Gazelle8087/Si4730-AM-FM-tuner/LED UI仕様.pdf

## LED表示UI仕様 2026/7/4時点未実装

LED番号 | 想定色 | | 点灯条件 複数は&& 数値はソースで定義 | 基板シルク表示 | 備考
1 | 白 | AM | SNR○○以上 帯域○klHz以上指示 | Hi-Fi | 最高の受信状態
| | FM | SNR○○以上 STBLEND○○以上 MULT○○以下 | FULL STEREO
2 青 | | AM | SNR○○以上 | CLEAR | 良好な受信状態
| | FM | PILOT検出 オートミュートON オートミュート不動作 強制モノラル OFF | STEREO PILOT | ステレオインジケーター
3 緑 | | AM | RSSI○○以上 | TUNE | 受信あり
| | FM | RSSI○○以上 | | 受信あり
4 | 赤 | 共通 | 微調整モード中 | FINE TUNING | 微調整モード表示
