Gazelle8087/Si4730-AM-FM-tuner/リモコンUI仕様.pdf

## リモコンUI仕様 2026/7/19時点

ボタン表示 | ボタンの働き | 備考
電源記号 | 音声mute ON/OFF トグル （電源 ON/OFFではない）
入力切替 | 予約（現状無動作）
放送切替 | AM/FM 切替トグル
音量+ | 音量+
音量- | 音量-
▲（上） | AM FM | 通常時：+9kHz 微調整：+1kHz | 通常時、9加算結果は9単位に丸められる　例 722▲⇒729
| | 通常時：+0.1MHz (100kHz) 微調整：+0.01MHz (10kHz) | 通常時、0.1加算結果は0.1単位に丸められる　例 82.42▲⇒82.5
▼（下） | AM FM | 通常時：-9kHz 微調整：-1kHz | 通常時、9減算結果は9単位に丸められる　例 722▼⇒720
| | 通常時：-0.1MHz (100kHz) 微調整：-0.01MHz (10kHz) | 通常時、0.1減算結果は0.1単位に丸められる　例 82.42▼⇒82.4
←（左） | | 通常時：プリセットCH-微調整：帯域幅（cannnel filter）-
→（右） | | 通常時：プリセットCH+ 微調整：帯域幅（cannnel filter）+
決定（中央） | | 通常/微調整 切替トグル | 十字キーの動きを切替
d | | 周波数直打(direct tuning) | 続けて数値3または4桁入力（AM 1kHz単位 FM 100kHz単位） 0～9以外入力された場合、キャンセル扱い
戻る | | 操作キャンセル | 周波数直打/プリセットメモリ書込CH選択キャンセル
メニュー | | プリセットバンク切替 | 続けて押されたch番号⇒バンク番号
番組表 | | プリセットメモリ書込 | 続けて押されたchに書き込み（選択中のバンク内ｃｈ）
青 | AM | 予約（現状無動作） | 同調容量指示（将来実装）
| FM | 強制モノラル ON/OFF トグル
赤 | AM | 予約（現状無動作） | オートボリューム操作（将来実装）
| FM | 予約（現状無動作） | オートミュート ON/OFF トグル（将来実装)
緑 | AM | RSQ定期更新停止/開始 トグル | 受信周波数変更で解除
FM
黄 | AM | 予約（現状無動作） | ゲイン値 強制指定（将来実装）
| FM | 予約（現状無動作）
1 | | 通常時：プリセットメモリ呼出 プリセットメモリ書込時： 書込CH指定 CHボタン以外押されたら キャンセル扱い プリセットバンク切替時： 選択するバンクNo指定 CHボタン以外押されたら キャンセル扱い 周波数直打時：数値キー 10 ⇒ 0 11 ⇒ キャンセル扱い 12 ⇒ キャンセル扱い | 選択中のプリセットバンク内の chボタンで指定されたチャンネルメモリを呼び出し AM/FM混合ランダム指定可能 AM/FM種別 周波数　帯域幅 強制モノラル を記憶する 合計144chプリセット バンク、ch 共に 1～9,A,B,C 表示
10 | ボタンの「10」はCHは10 周波数直打時は0 と解釈
11 | 11,12 は周波数直打数値キーとしては無効（キャンセル扱い）

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
