Gazelle8087/Si4730-AM-FM-tuner/搭載LCD仕様一覧.pdf

搭載LCD型番仕様差　搭載方向ごとの周辺RC実装要否
型式 | 型番 | 秋月 販売コード | バック ライト色 | 背景色 | 文字色 | 搭載方向 | R13 | R14 | R15 | R21 | C10 | C12 | C13 | C14 | C15 | C16
薄型 DIP変換KIT付 | AE-AQM1602A(KIT) | 108896 | - | 白 | 黒 | 正立 倒立 | × | × | × | × | × | × | × | × | × | ×
薄型 1.27mmピッチ | AQM1602XA-RN-GBW | 108779 | - | 白 | 黒 | 正立 | ○ | ○ | × | ○ | × | × | × | ○ | ○ | ○
| | | | | | 倒立 | ○ | ○ | ○ | × | ○ | ○ | ○ | × | × | ×
超小型 2.54mmピッチ | AQM1602Y-RN-GBW | 111916 | - | 白 | 黒 | 正立 | ○ | ○ | ○ | × | ○ | ○ | ○ | × | × | ×
| AQM1602Y-NLW-BBW | 112485 | 白 | 青 | 白
| AQM1602Y-NLW-FBW | 112486 | 白 | 黒 | 白
| AQM1602Y-FLB-FBW | 112618 | 青 | 青 | 白
| AQM1602Y-FLW-FBW | 112619 | 白 | 白 | 黒
| AQM1602Y-RN-GBW | 111916 | - | 白 | 黒 | 倒立 | ○ | ○ | × | ○ | × | × | × | ○ | ○ | ○
| AQM1602Y-NLW-BBW | 112485 | 白 | 青 | 白
| AQM1602Y-NLW-FBW | 112486 | 白 | 黒 | 白
| AQM1602Y-FLB-FBW | 112618 | 青 | 青 | 白
| AQM1602Y-FLW-FBW | 112619 | 白 | 白 | 黒

薄型 DIP変換KIT付使う場合はピッチ変換基板上のプルアップジャンパをON（ショート）
