Gazelle8087/Si4730-AM-FM-tuner/LCD表示UI仕様.pdf

LCD表示UI仕様 2026/7/4時点

1 2 3 4 5 6 7 8 9 10 11 12 13 14 15 16
AM | P b c | 1 0 5 3 < v v | 6 . 0
R r r | S s s A a a C c c c
FM | P b c 8 2 . 5 0 < v v | 1 1 0
R r r | S s s Mmm B b b b
| 桁
1行目 | 1-3 | Pbc　b：バンク番号 c：ch番号
| 5-9 | 周波数表示
| 10 | ファインチューニング時 < 表示　通常時 空白
| 11-12 | 音量表示 音声mute時は [--]
| 14-16 | チャンネルフィルタ値　FM自動選択維持はAと表示
2行目 | 1-3 | Rrr RSSI値
| 5-7 | Sss SNR値
| 9-11(AM) | Aaa ATT値
| 9-11(FM) | Mmm マルチパス指標
| 13-16（AM) | Cccc 同調バリキャップ容量 ( pF )
| 13-16(FM) | Bbbb ステレオブレンド値 ( % ) PILOT検出時 [B] 表示 強制モノラル時 [---]表示
