Gazelle8087/Si4730-AM-FM-tuner/部品表.pdf

部品表
| 部品番号 | 型番 または諸元 | 個数 | 購入可能ショップ（例）ショップURL または 秋月販売コード
プリント基板 | | | 1 | JLCPCB | https://jlcpcb.com/jp
チューナーモジュール | | Si4730-M02 | 1 | 共立エレショップ | https://eleshop.jp/shop/g/gQ1D411
液晶表示器 | | AE-AQM1602A(KIT) | 1 | 秋月電子 | 108896 薄型液晶DIP変換キットを標準仕様とします
マイコン | U2 | ATMEGA328P-PU | 1 | 秋月電子 | 103142
丸ピンICソケット | U2 | 28ピン 300mil | 1 | 秋月電子 | 101339
ミュートトランジスタ | Q1,Q2 | 2SC2878 | 2 | 樫木総業 | https://www.kashinoki.shop/?mode=srh&cid=&keyword=2SC2878
赤外線受光器 | U3 | OSRB38C9AA | 1 | 秋月電子 | 104659 （2個セット）
3.3Vレギュレータ | U1 | LP2950L-33-T92 | 1 | 秋月電子 | 108749
ショットキーダイオード | D3 | 1S4 | 1 | 秋月電子 | 100127
スイッチングダイオード | D8 | 1SS178 | 1 | 秋月電子 | 107783 （100本セット）
DCジャック | J3 | 内径2.1 外径5.5 | 1 | 秋月電子 | 109408
RCAジャック | J5 | MJ-523-W 白 | 1 | 秋月電子 | 116497
RCAジャック | J6 | MJ-523-R 赤 | 1 | 秋月電子 | 116498
3.5mmステレオジャック | J7 | ST-005-G | 1 | 秋月電子 | 102460
電源スイッチ | J2 | SS-12D00G3 | 1 | 秋月電子 | 115707
リセットスイッチ | SW1 | タクトスイッチ | 1 | 秋月電子 | 103648
ヘッダピン | J12 | PH-1x40SG | 1 | 秋月電子 | 108593 （10個セット）
ジャンパプラグ | J12 | MJ-254-6R | 1 | 秋月電子 | 103688 （25個セット） USB-シリアルアダプタ経由給電時にセット
シリアルヘッダ | J11 | L型 6P | 1 | 秋月電子 | 105336
インダクタ | FB2,3 | 10μH | 2 | 秋月電子 | 103963 （10本セット）
アルミ電解コンデンサ | C19,20 | 100μF | 2 | 秋月電子 | 110271
アルミ電解コンデンサ | C4,6,8 | 10μF | 3 | 秋月電子 | 117897
積層セラミックコンデンサ | C5,7,9,11,17,18,24 | 0.1μF | 7 | 秋月電子 | 113582 （10個セット） C21は実装しない（設計ミス）
抵抗 | R1 | 33kΩ 1/6W | 1 | 秋月電子 | 116333 （100本セット）
↑ | R4,5 | 22kΩ 1/6W | 2 | 秋月電子 | 116223 （100本セット）
↑ | R2,18,21,22 | 10kΩ 1/6W | 4 | 秋月電子 | 116103 （100本セット）
↑ | R3,6,C7 | 1kΩ 1/6W | 3 | 秋月電子 | 116102 （100本セット）
↑ | C16,17,23,24 | 100Ω 1/6W | 4 | 秋月電子 | 116101 （100本セット）

機能使うなら実装するオプション部品
USB-Aコネクタ | J8 | 5075AR-04-WH | 1 | 秋月電子 | 100160 DAISO 300円スピーカーに電源供給するなら実装
電源パイロット LED | D2 | お好みの色 | 1 | | パイロットLEDは5Vから供給
抵抗 パイロット電流制限 | R8 | 輝度見ながら調整 | 1
抵抗 LCDバックライト用 | R19, R20 | 輝度見ながら調整 | 2 | | バックライトは5Vから供給
ヘッダピン | J17 | 2×3 | 1 | 秋月電子 | 116883 ICSPヘッダ
LCD用抵抗 | R13,14 | 10kΩ | 1 | 秋月電子 | 116103 （100本セット）超小型LCD搭載の場合に実装（方向問わず）
LCD用抵抗 | R15 | 10kΩ | 1 | 秋月電子 | 116103 （100本セット）超小型LCDを非反転で搭載する場合に実装
LCD用コンデンサ | C10,12,13 | 1μF | 3 | 秋月電子 | 115940 （10個セット） 超小型LCDを非反転で搭載する場合に実装
LCD用抵抗 | R21 | 10kΩ | 1 | 秋月電子 | 116103 （100本セット）超小型LCDを上下反転で搭載する場合に実装
LCD用コンデンサ | C14,15,16 | 1μF | 3 | 秋月電子 | 115940 （10個セット） 超小型LCDを上下反転で搭載する場合に実装
積層セラミックコンデンサ | C1,2 | 0.1～1μF | 2 | | ポップノイズチューニング用
マイコン横ピンソケット | J15,16 | 14ピン | 2 | 秋月電子 | デバッグ用にジャンパワイヤ刺す際に便利

基板にパターンはあるが実装しないファームウエア未対応部品
整流ダイオード | D1 | 1N4007 | 1 | | 100934（20本セット）
インダクタ | FB1 | 10μH | 1
水晶発振子 | Y1 | 8MHz | 1 | | Arduino UNO等から取り外したマイコンにブートローダー
水晶発振負荷コンデンサ | C22,C23 | 22pF | 2 | | 書き込む際には必要な場合あり
UI用LED | D4 | お好みの色 | 1
UI用LED | D5 | お好みの色 | 1
UI用LED | D6 | お好みの色 | 1
UI用LED | D7 | お好みの色 | 1
抵抗 LED用 | R9 | 輝度見ながら調整 | 1
抵抗 LED用 | R10 | 輝度見ながら調整 | 1
抵抗 LED用 | R11 | 輝度見ながら調整 | 1
抵抗 LED用 | R12 | 輝度見ながら調整 | 1
SPI接続 7SEG LED | | 7SEG 8桁 | 1 | Amazon等
パスコン 7SEG LED用 | C3 | 0.1μF | 1

スケッチ書き込みに使うUSB-シリアルアダプタ
USB-シリアルアダプタ | AE-TTL-232R | 1 | 秋月電子 | 111007
マイクロUSBケーブル | | 1 | 秋月電子 | 107607

ACアダプタ
5VＡＣアダプタ | AD-T50P200 | 1 | 秋月電子 | 111996　USB-シリアルアダプタから給電する場合は不要

リモコン送信機
ELPA TVリモコン | RC-TV013UD | 1 | ホームセンタ 家電量販店など | https://www.elpadirect.jp/products/4901087205325/

アンテナ

AMループアンテナ | 1 | Amazonなど | リード線先端がコネクタではなく裸線の物をご用意ください

木道家屋または窓際設置であればAMはループアンテナで十分受信可能　FMはワイヤーアンテナでは良好な受信は期待できません
