Gazelle8087/Si4730-AM-FM-tuner/Si4730-M02_manual.JPG

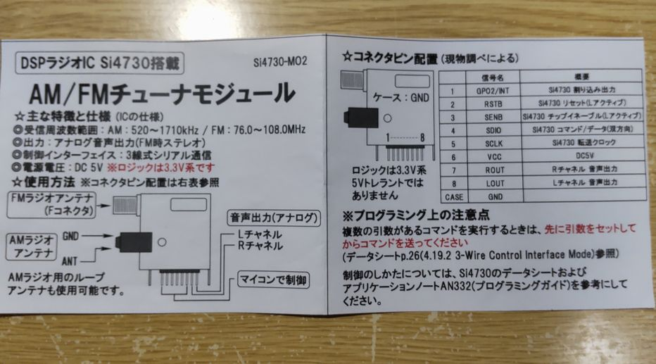
Si4730-M02_manual.JPG
