Gazelle8087/Si4730-AM-FM-tuner/使ったリモコン_rc-tv013ud_manual.pdf

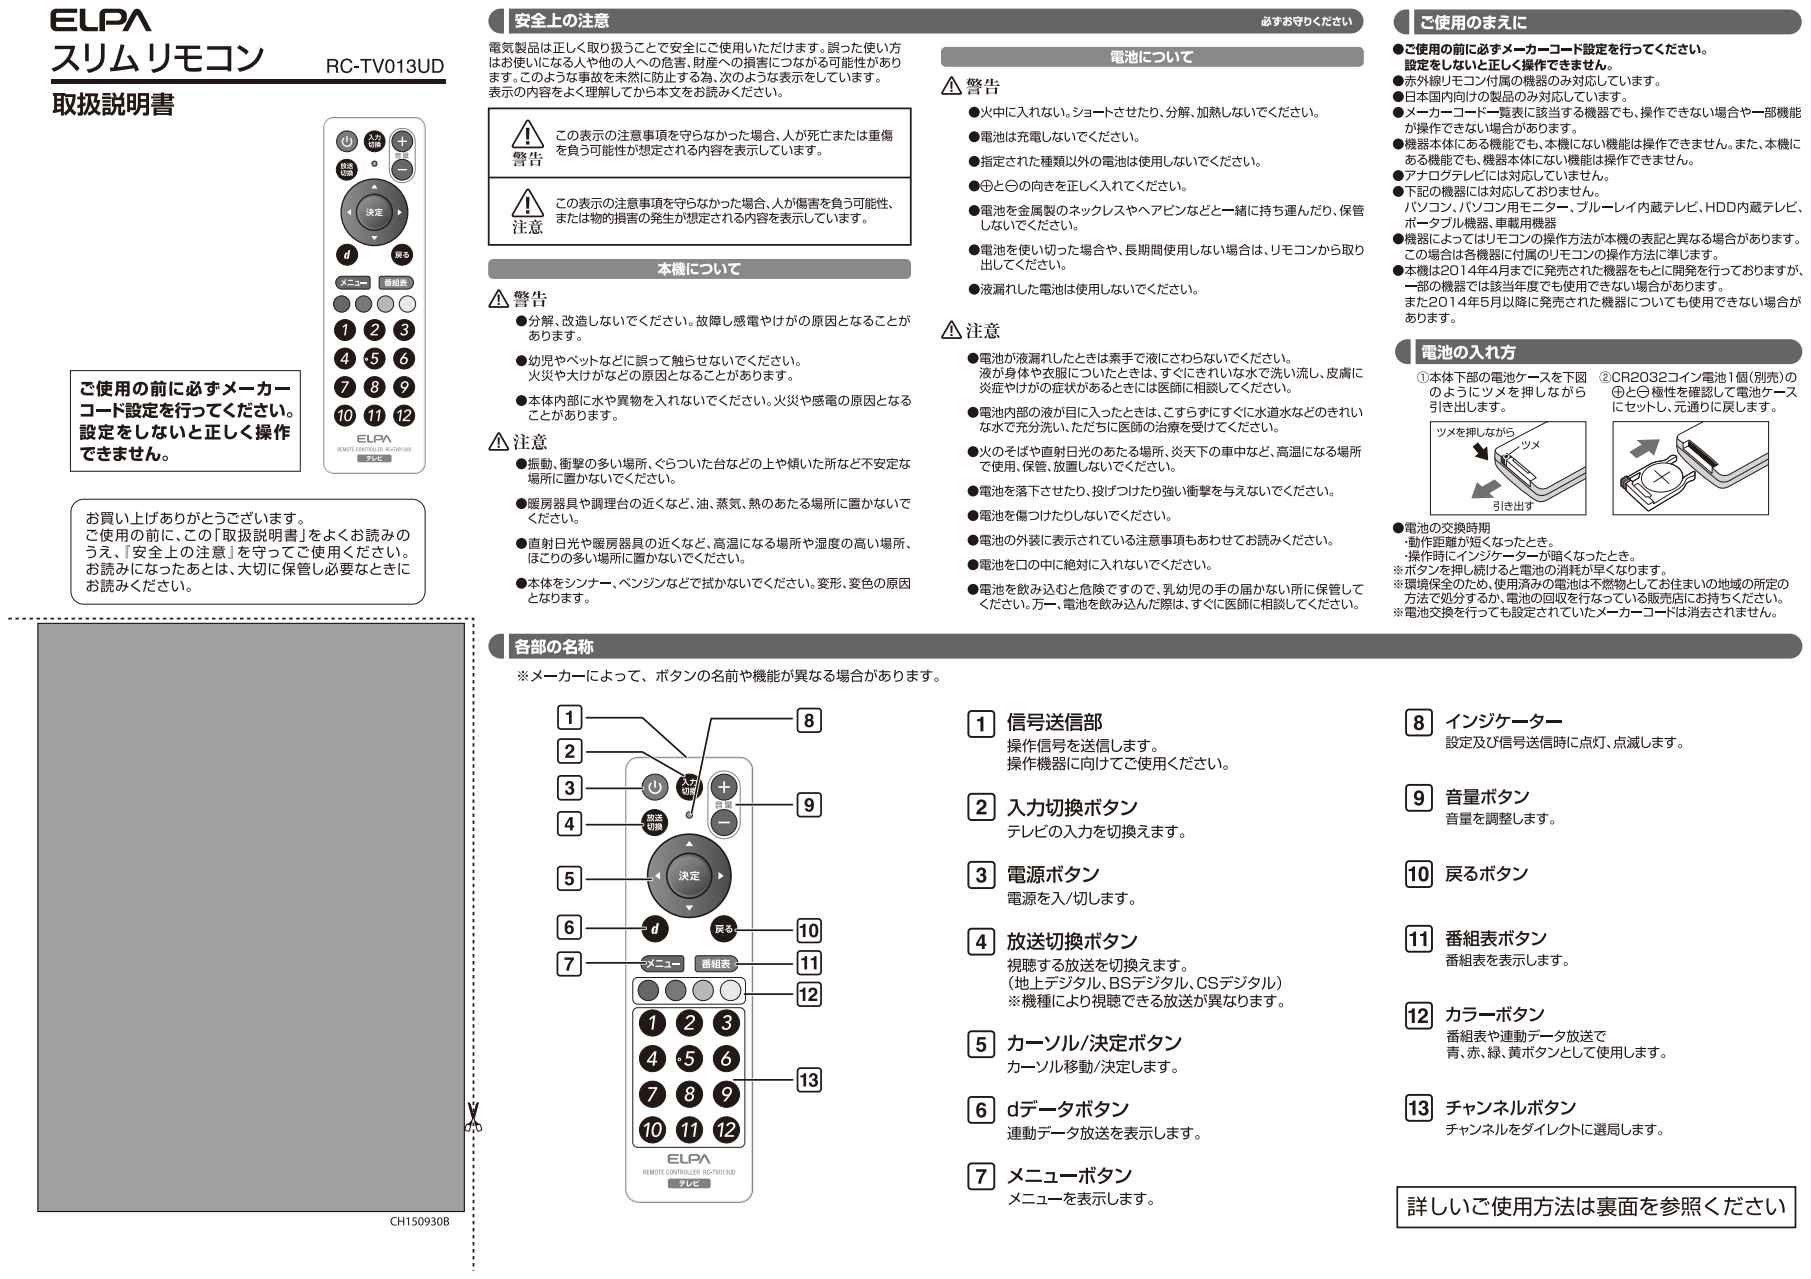
[picture p6: page 1]

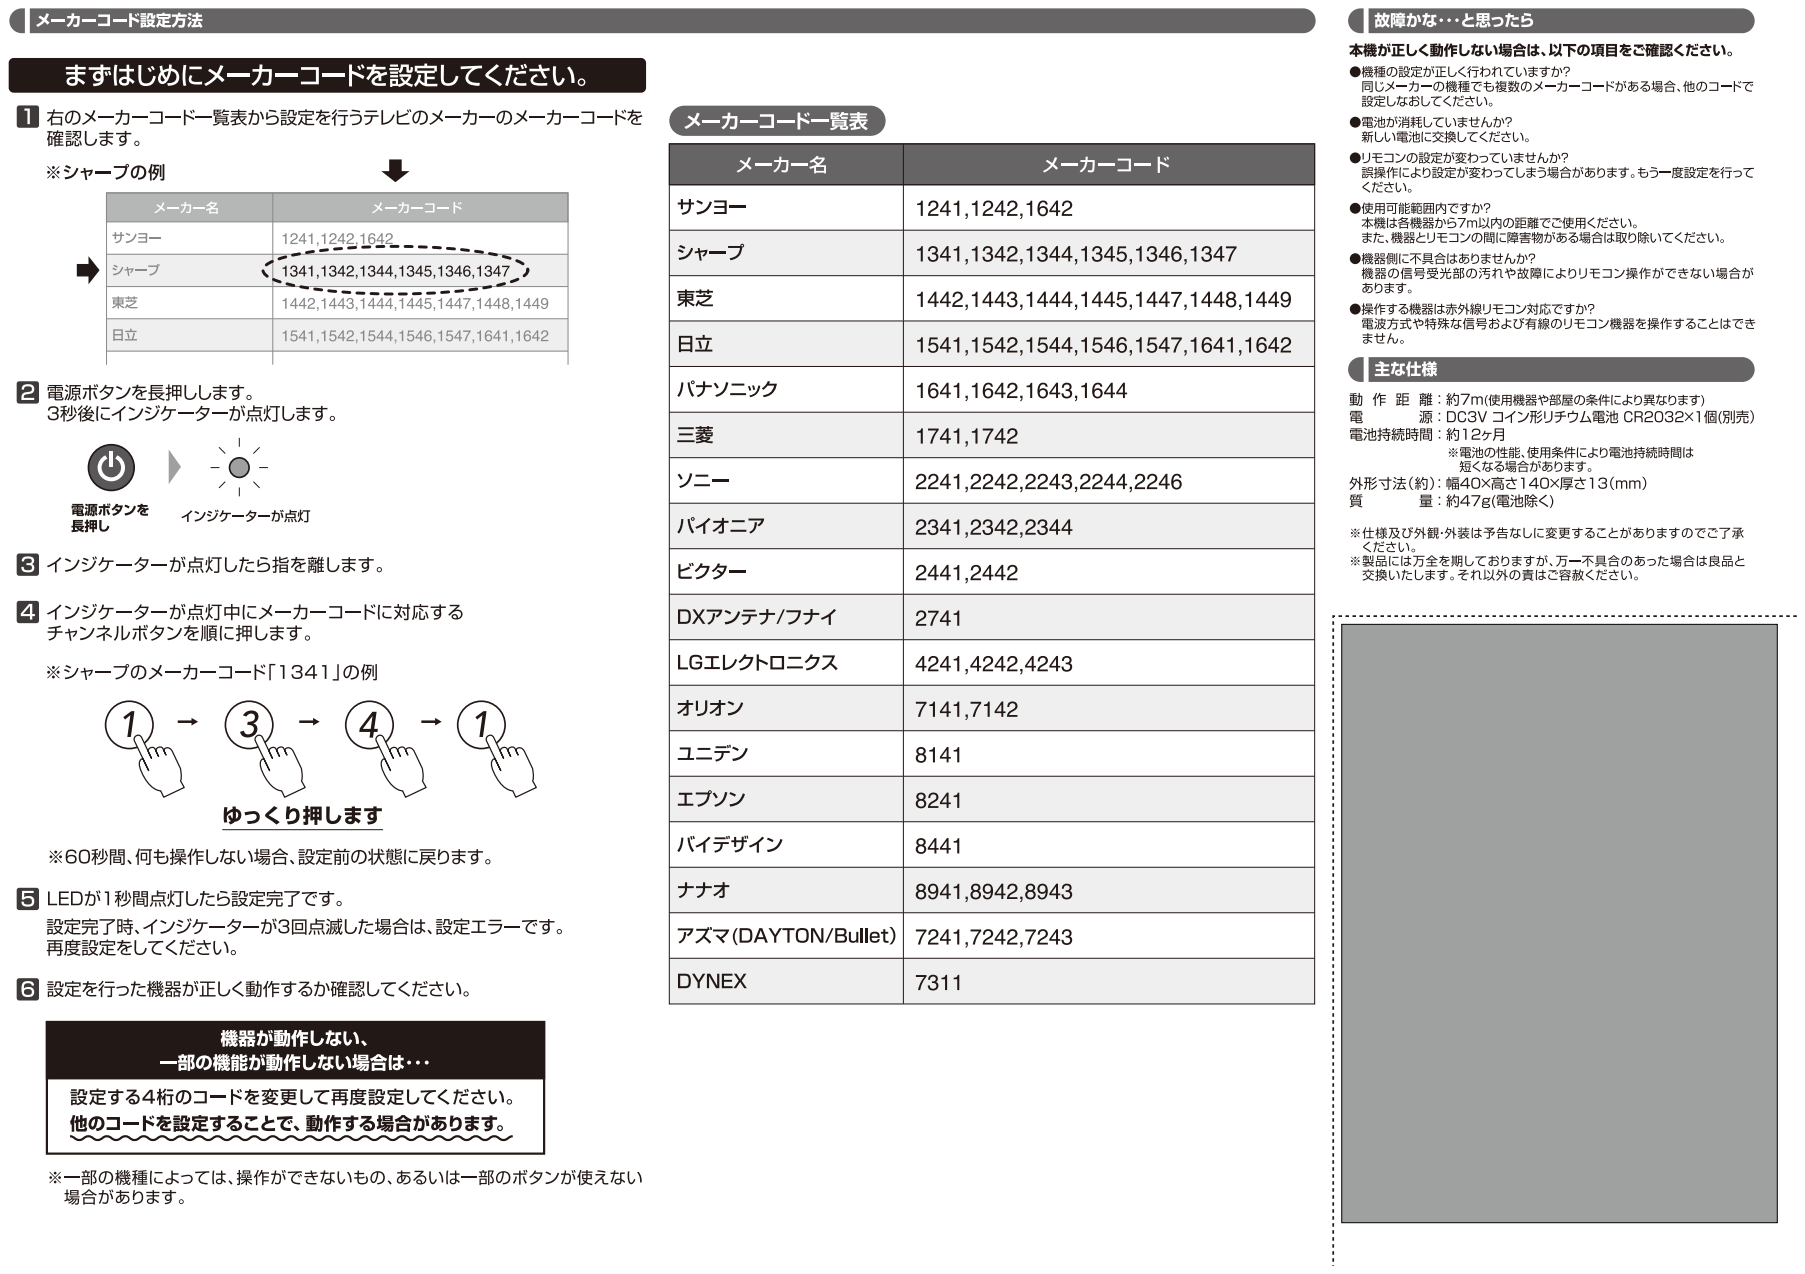
[picture p7: page 2]
