Gazelle8087/Si4730-AM-FM-tuner/Si4730-M02_Tuner_sch.pdf

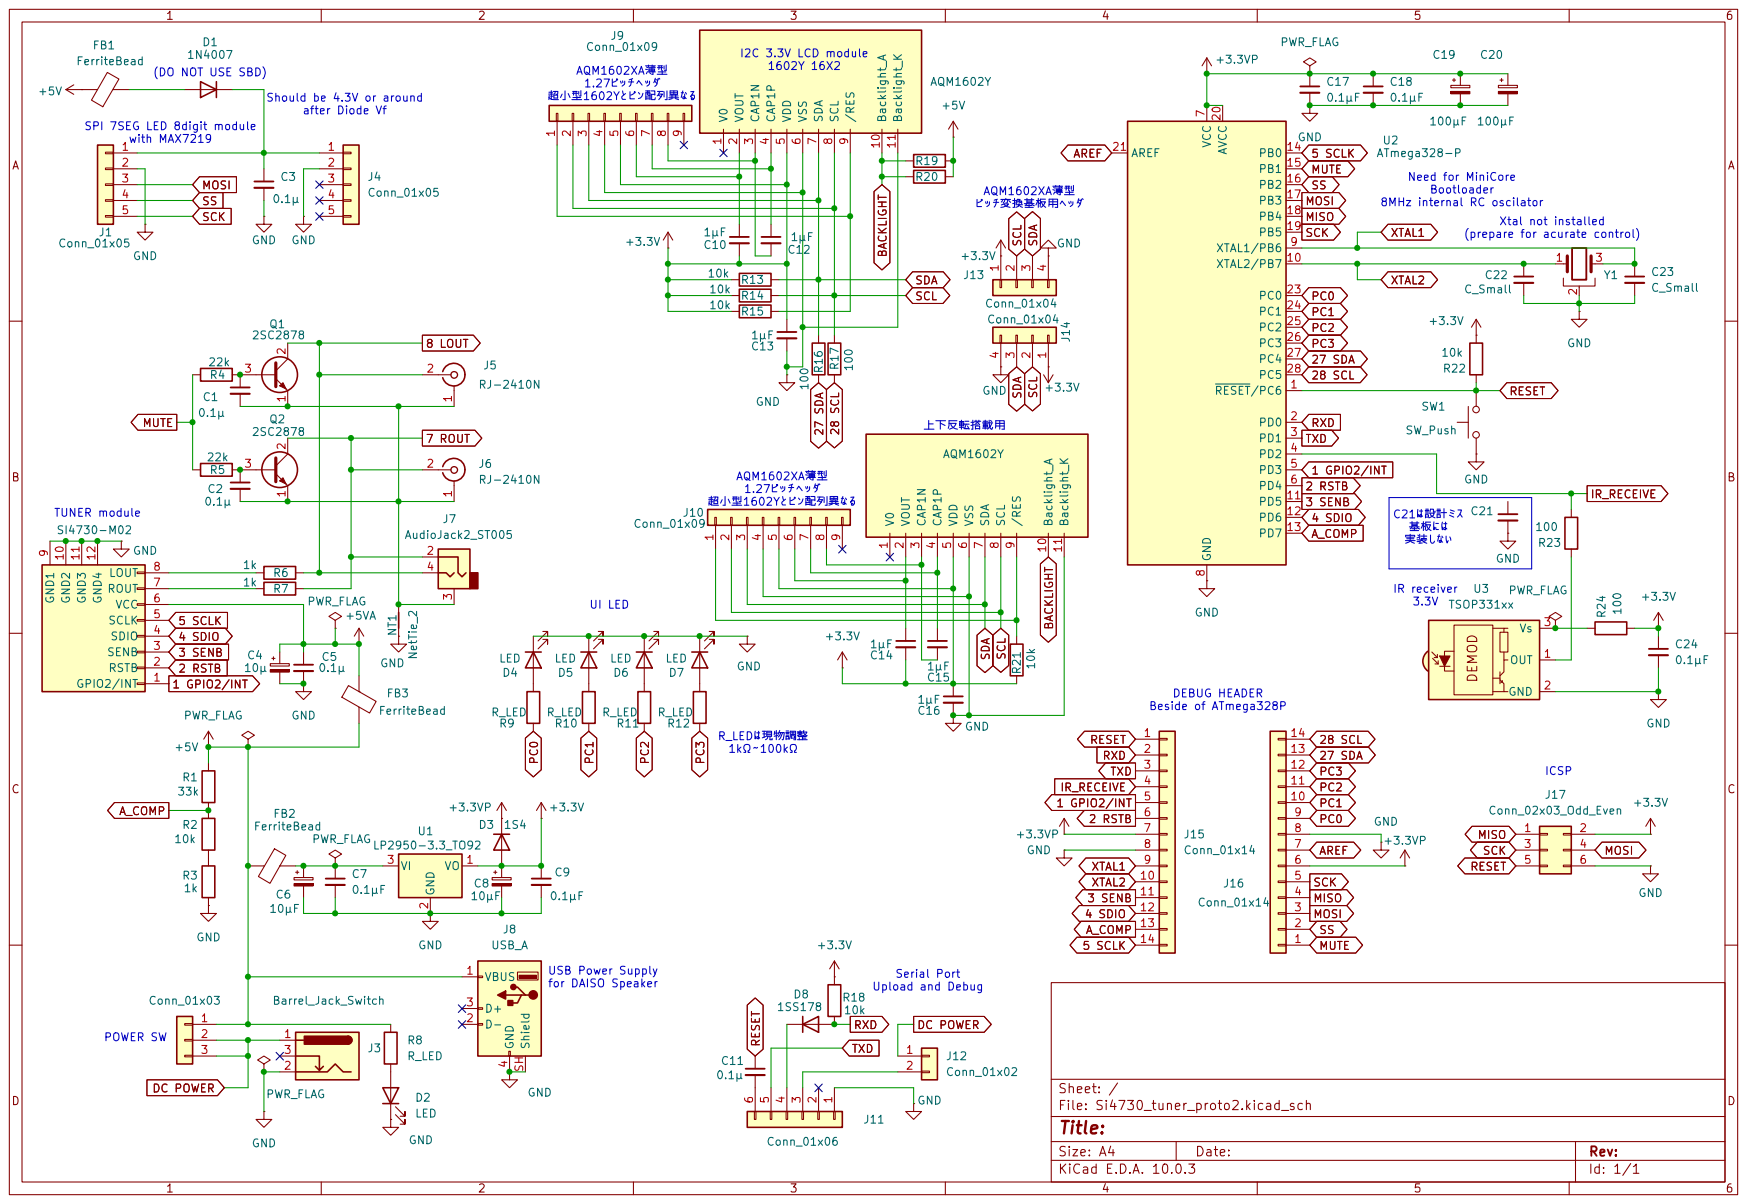
[picture p8: page 1]
