Gazelle8087/Si4730-AM-FM-tuner/Si4730-M02_sch.pdf

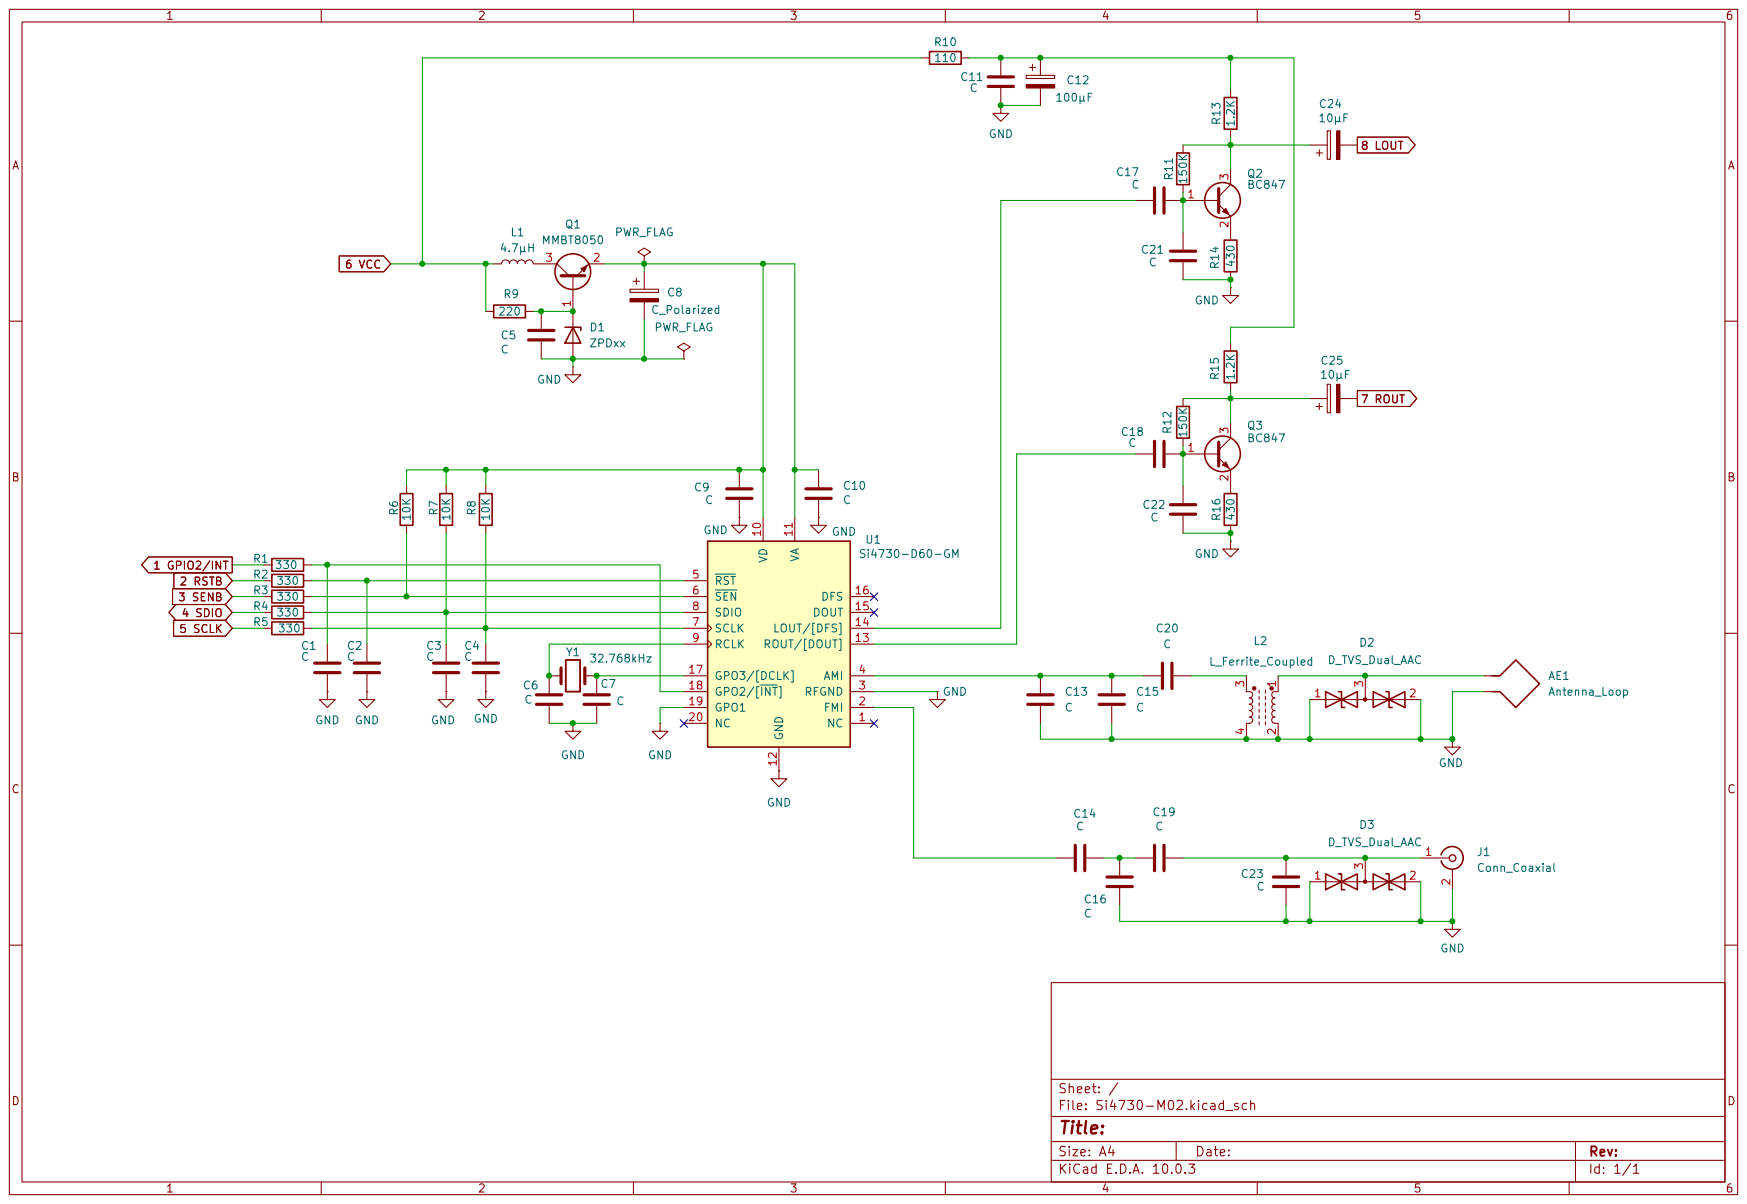
[picture p9: page 1]
