Gazelle8087/Si4730-AM-FM-tuner/5075AR-04-WH-F1.pdf

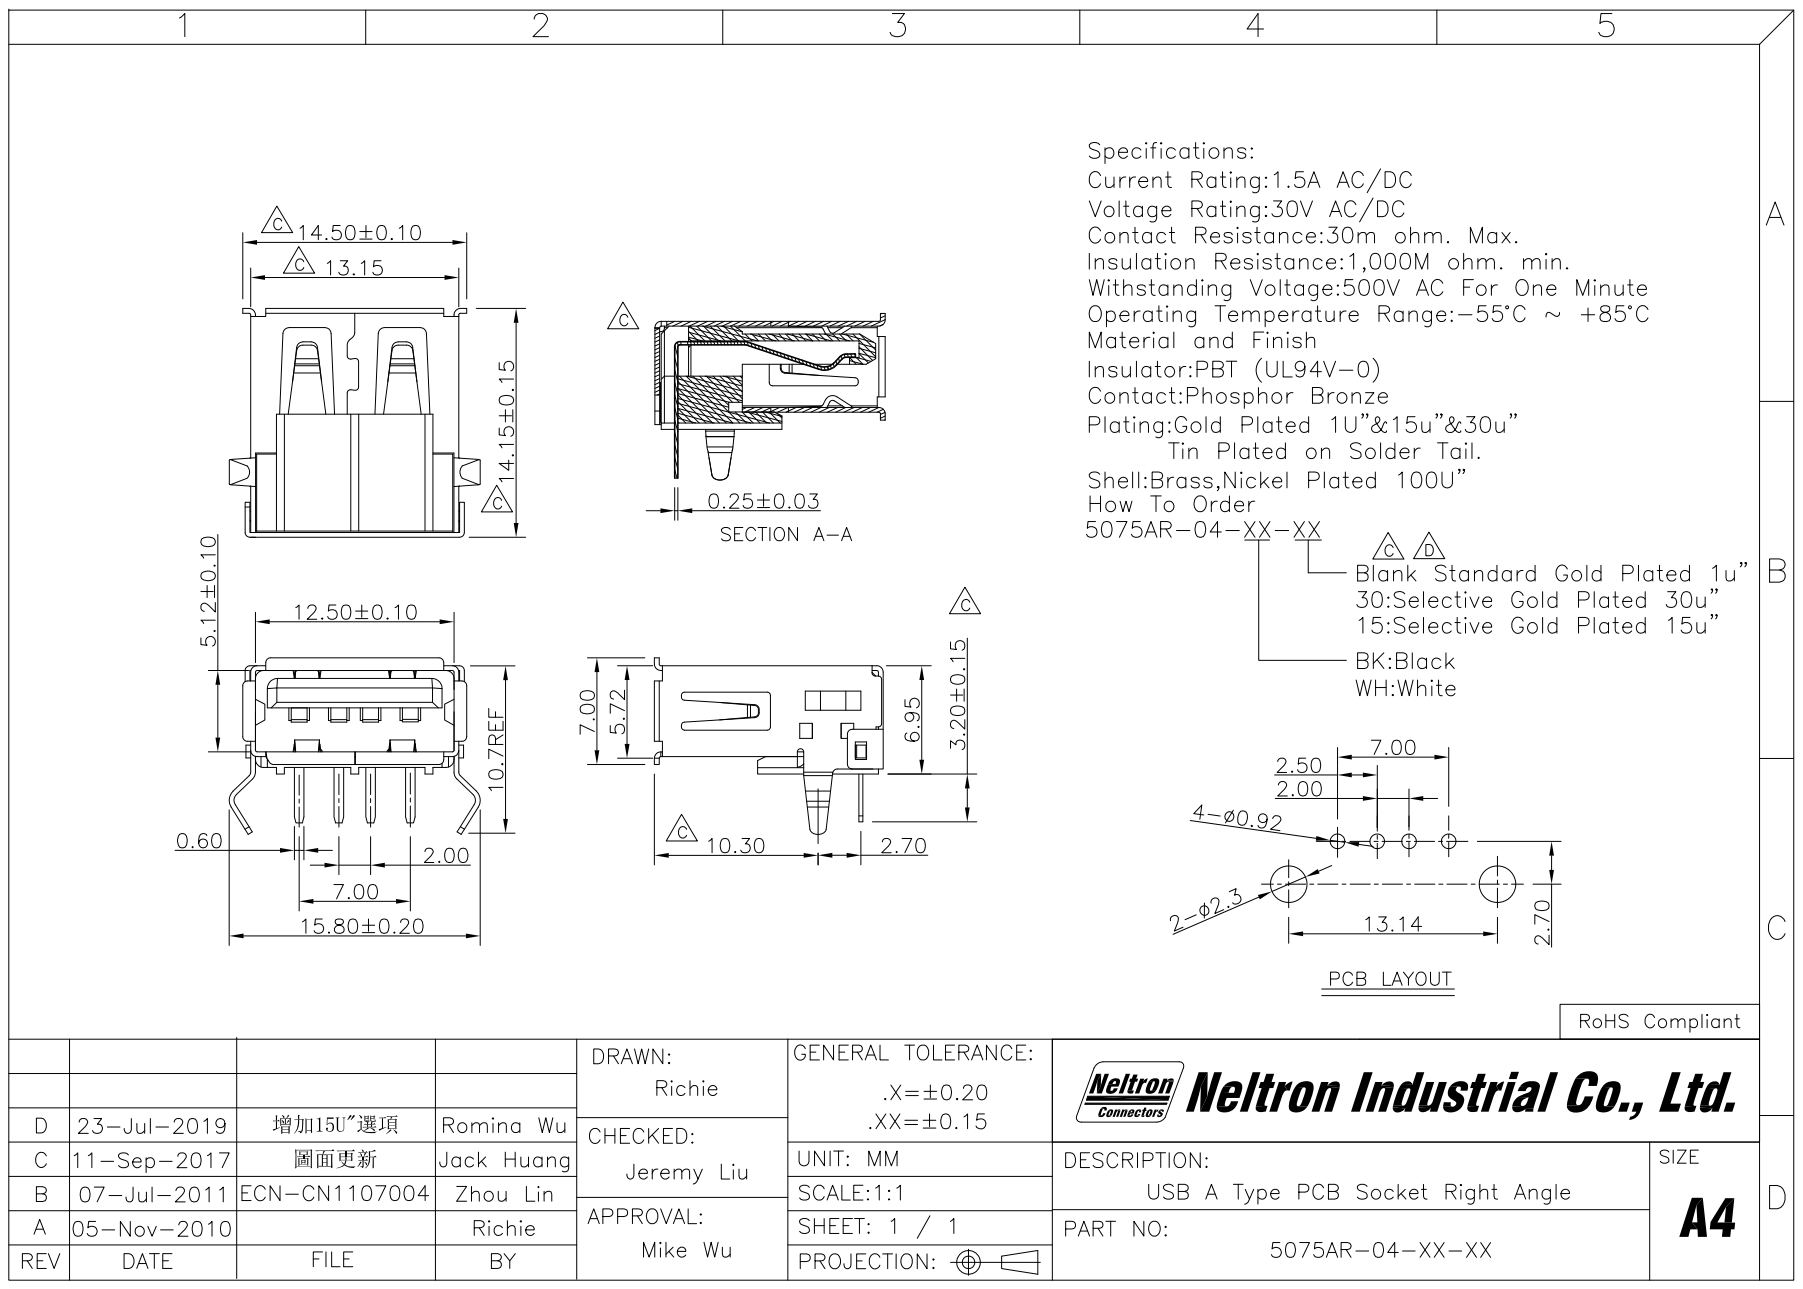
[picture p10: page 1]
