Gazelle8087/Si4730-AM-FM-tuner/ST-005-G.pdf

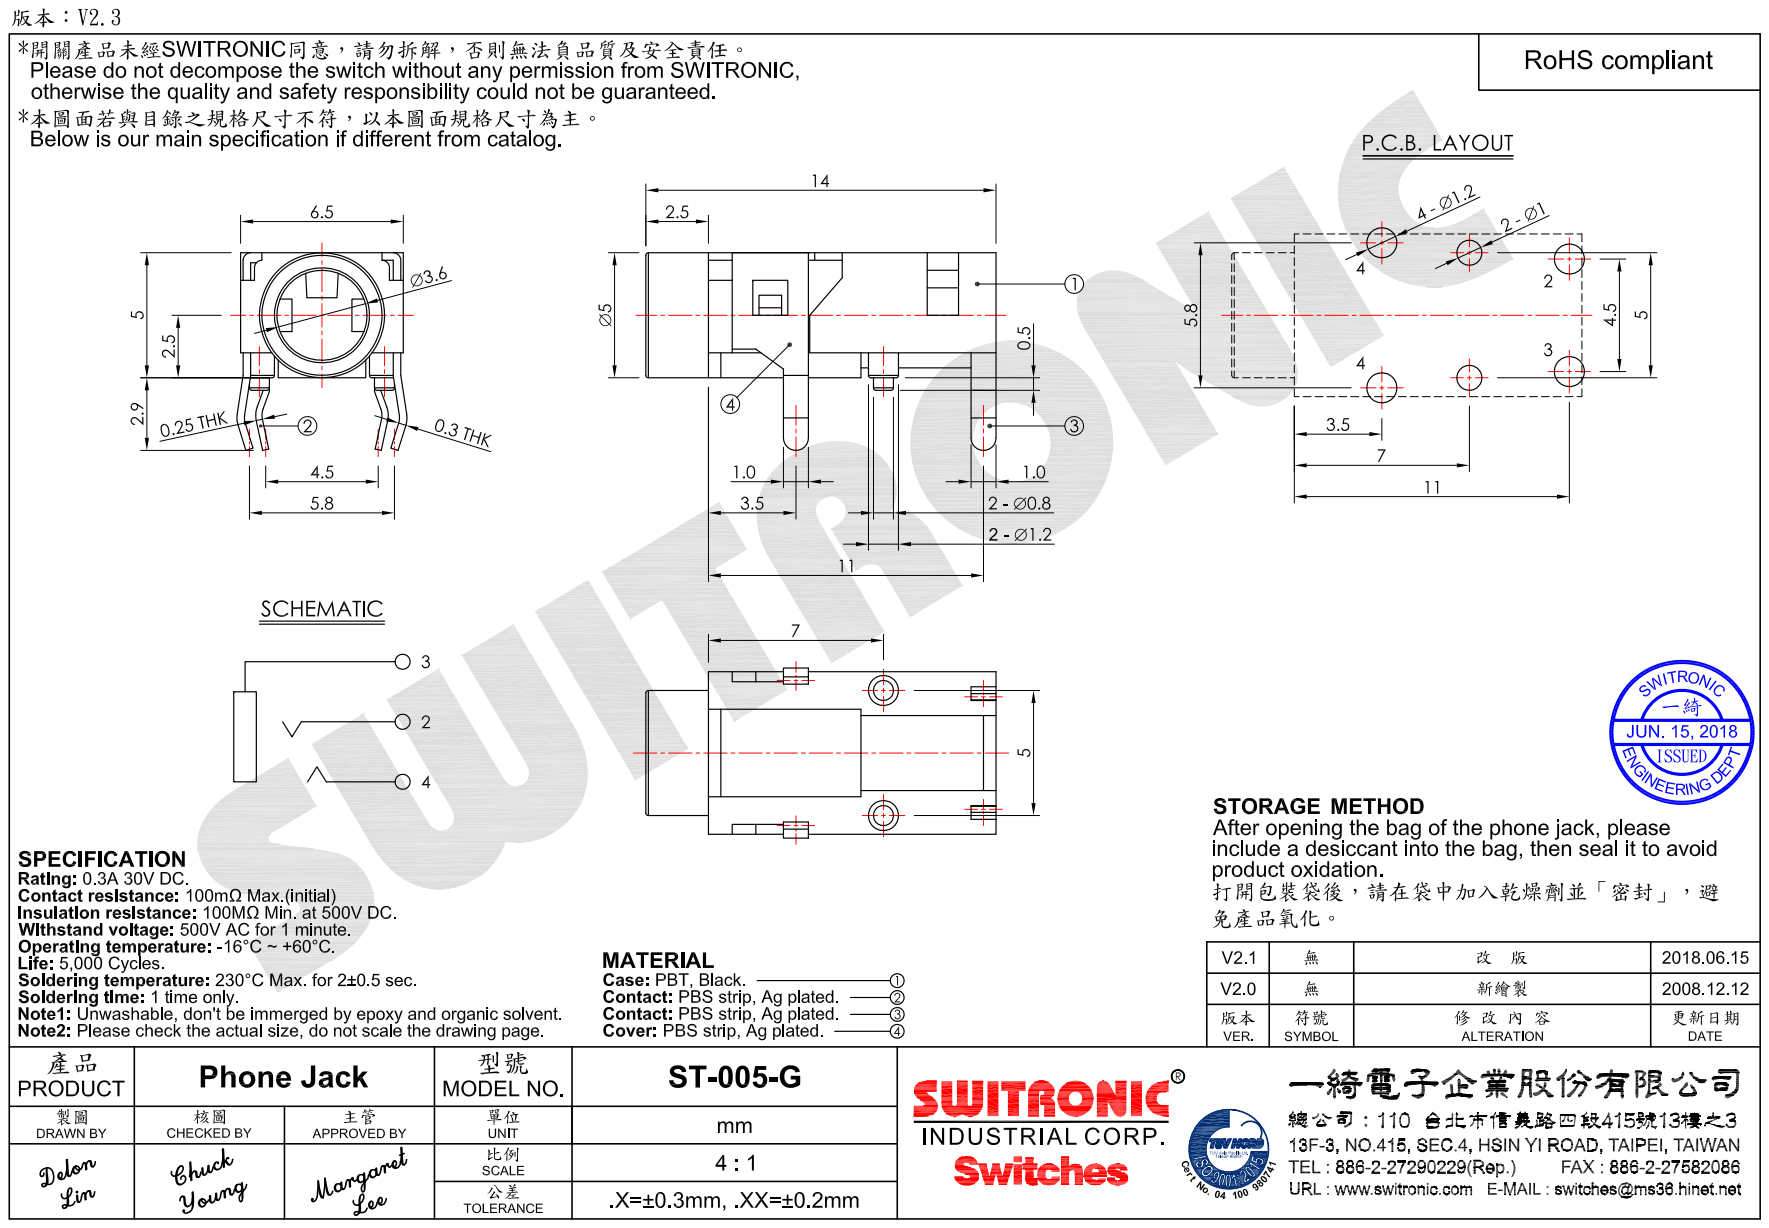
[picture p11: page 1]
